eSpark-Consulting-Group/royluo-ledboard/README.md

# LED Board
#### Client Name: Roy Luo

## Project Requirements
### High Level PCB Requirements
- The PCB must be about 1.5cm by 1.5cm, with LED bulb extruding outwards in direction of the plane.
- Battery holder must be attached to the bottom of PCB board, and within that 1.5cm by 1.5cm dimension constraint.
- Battery holder will hold 2 CR1216 or CR1220 batteries, providing a battery life of at least 5 hours.
- Components must be chosen and sourced based on availability - we want components to be immediately available or available within at most 2 weeks for manufacturers to solder onto the PCB. Preferred is JLCPCB.
- The LED light will be flashing different colours, at different rates, to produce unique patterns when in motion, all of which is to be programmed and controlled via the microcontroller.
- Safety of the device is of high importance

### Key Electrical Components
- Addressable LED
    - Flashes 3 different colours at the same time
    - 16 possible colour options - can be reduced to save implementation costs
- Microcontroller
    - holds in memory the programmed colour settings (This point does not mean the memory should be retained when device goes off, it only means all the color combinations reside in flash so that they can be activated when device is ON)
    - controls the logic for user to change colour settings
- Button
    - Turns LED on/off (On press and hold of the button)
    - Sets light to colour selection mode
    - Cycle through colour selection
- Battery
    - 2 x CR1216 or CR1220 equivalent

### High Level Firmware Requirements
There are 3 states for the LED light:
1. OFF State
2. ON State
3. Cycle (Color Selection) State

- Pressing button once from OFF state turns LED to ON state
    - LED turns on upon release of button, not when button is pressed down
    - When in ON state, it will flash the first flash pattern in the cycle of patterns
- Pressing button once from ON state will make the LED flash the next pattern in the cycle
    - Pressing the button on the last pattern will take the user to the first pattern
- Pressing button and holding for 2 seconds from ON state turns LED to OFF state
- Pressing button and holding for 2 seconds from OFF state turns LED to Colour Selection state
    - LED will flash green for 2 seconds before entering colour selection mode
    - After the green flash the LED will stay on the first colour of the colour palette
    - Subsequent presses of the button will cycle the user through the colour palette
    - To choose a colour, press and hold on the desired colour, and the LED will flash that colour on and off for 1 second before returning to the first colour selection again
    - Repeat this 3 times to select the 3 colour choices, and after the final colour is selected, LED will flash the first flash pattern with the new colours
 
### Color Palette


### Strobe Pattern
Below are 5 strobe patterns we would like LED to be able to flash. Such patterns are made visible to the eye by waving the LED light around in circular motion.

#### 1. Standard Strobe


#### 2. Long Strobe


#### 3. Dots


#### 4. Flicker


#### 5. Streamline/ribbon


### Reference Product Images
