eSpark-Consulting-Group/royluo-ledboard/Docs/RD-CR1220-2 THM Type from Reida company.pdf

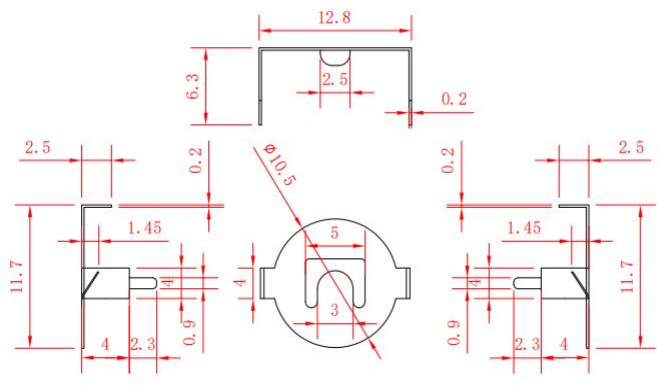
[picture p1: figure]

比例 SCALE | 单位 UNIT | 版本 REV. | 尺寸范围 SIZE RANGE | 公差 TOLERANCES | 零件编号 PART NO. | RD-CR1220-2 | 瑞达五金电子制品（东莞市）有限公司 LTD
| MM | A | XX. ±0.50 XX.X ±0.20 XX.XX ±0.10 XX.XXX ±0.05 GENERAL TOLERANCES PER ISO 2768-K | | 材料 MATERIAL | 0.20MM Mn STEEL | Reida Hardware Electronic (Dongguan) Co., 2X
制图 DRAWING | 审核 CHECKING | 核准 APPROVAL | | 表面处理 FINISH | 镀 镍 NICKEL PLATE | 零件名称 PART NAME | CR1220 BATTERY CLIP
CARSON | PETTER | J.L | | 日期 DATE | 2019/10/20 | 图纸编号 DWG NO. | RD-CR1220-2
