eSpark-Consulting-Group/royluo-ledboard/Design-Files/BOM/Royluo-Client-BOM.xlsx

# | Item Type | Designator | Description | Footprint | Manufacturer Part Number | Manufacturer | Value | Quantity | Remarks
1 | Capacitor | C1, C2, C3 | CAP CER 0.1UF 16V X7R 0402 | Cap-0402 | GRM155R71C104KA88D | Murata | 0.1uF | 3
2 | Capacitor | C4, C5 | CAP CER 10UF 10V X5R 0402 | Cap-0402 | CL05A106MP5NUNC | Samsung | 10uF | 2
3 | Capacitor | C6 | CAP CER 1UF 16V X5R 0402 | Cap-0402 | CC0402KRX5R7BB105 | Yageo | 1uF | 1
4 | Diode | D1 | 75V Dual 1.25V@150mA 4ns 150mA SOT-323 Switching Diode ROHS | SOT_323 | BAV99W | MSKSEMI | - | 1
5 | Connector | J1 | CR1220 2 cell connector | Custom | RD-CR1220-2 | Reida | - | 1 | Alibaba (https://www.alibaba.com/product-detail/Hot-Sale-DIP-Double-CR1220-Battery_1600451746414.html)
6 | RGB LED | LED1 | Plugin,D=5mm RGB LEDs ROHS | Custom | WS2812D-F5 | Worldsemi | - | 1
7 | Resistor | R1 | RES 75 OHM 5% 1/16W 0402 | Res-0402 | RC0402JR-0775RL | Yageo | 75R | 1
8 | Resistor | R2 | RES 10K OHM 1% 1/16W 0402 | Res-0402 | RC0402FR-0710KL | Yageo | 10K | 1
9 | Resistor | R3 | RES 1K OHM 1% 1/16W 0402 | Res-0402 | RC0402FR-071KL | Yageo | 1K | 1
10 | Resistor | R4 | RES 4.7K OHM 1% 1/16W 0402 | Res-0402 | RC0402FR-074K7L | Yageo | 4.7K | 1
11 | Tactile Switch | SW1 | 3.35mm 2.5mm Oval button 50mA Brick nogging 4.2mm 180gf 12V SMD Tactile Switches ROHS | Custom | TSA016A2518A | BZCN | - | 1
12 | IC | U1 | IC MCU 8BIT 4KB FLASH 8SOIC | SOIC-8(0.154", 3.90mm Width) | ATTINY412-SSNR | Microchip | - | 1
13 | LED Drivers | U2 | IC LED DRVR RGLTR 100MA SOT23-6 | SOT-23-6 | AP3602AKTR-G1 | Diodes | - | 1
14 | Peripheral | - | Coin Cell CR1220 | - | - | - | - | 2 | Aliexpress (https://www.aliexpress.com/item/1005006434761927.html)
