eSpark-Consulting-Group/royluo-ledboard/Design-Files/Supporting Files/royluo-ledboard.step

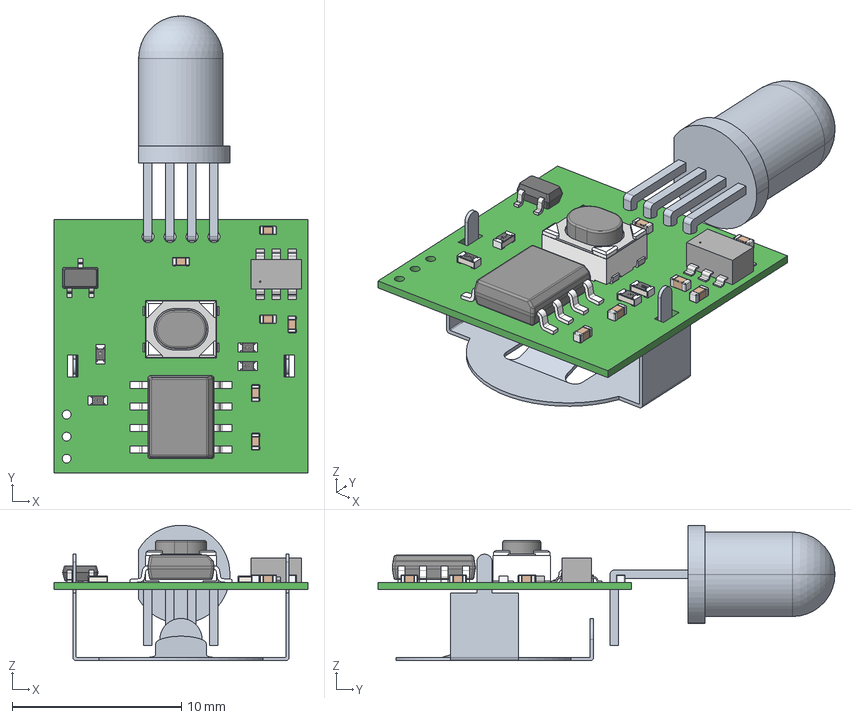
[picture p2: CAD file, 2024-05-24]
Design-Files/Supporting Files/royluo-ledboard.step
15.0 x 27.0 x 8.01 mm
LED
CR1220-2CELL
21-0058I_MXM
BODY-SO
LEAD-D0008A x 8
User Library-RES_1005-0402 x 4
User Library-sc70-3
User Library-Capacitor 0402 x 6
