eSpark-Consulting-Group/royluo-ledboard/(list of files, cad)

Other CAD files:
Design-Files/Supporting Files/royluo-ledboard.DWG
Design-Files/Supporting Files/royluo-ledboard.DXF
