eSpark-Consulting-Group/royluo-ledboard/Design-Files/Schematic/royluo-ledboard.pdf

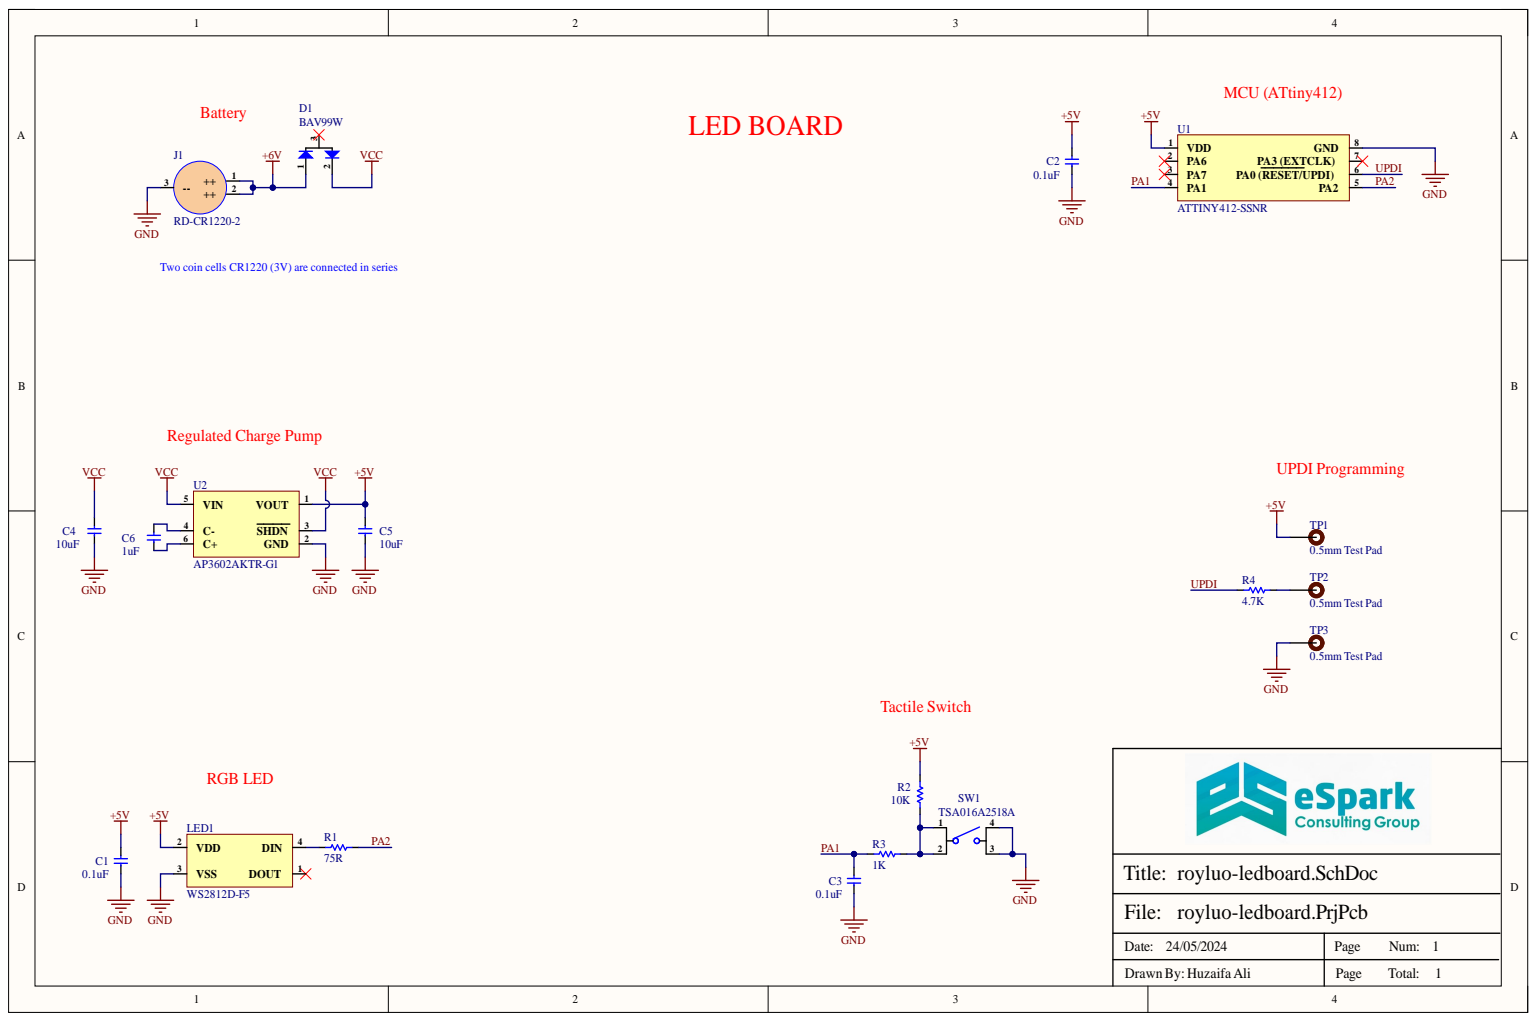
[picture p3: page 1]

Two coin cells CR1220 (3V) are connected in series
