eSpark-Consulting-Group/royluo-ledboard/(list of files, drawings)

Other design files:
Design-Files/royluo-ledboard.PcbDoc
Design-Files/royluo-ledboard.PrjPcb
Design-Files/royluo-ledboard.SchDoc
