eSpark-Consulting-Group/royluo-ledboard/(commit log)

2024-05-17 gitignore added. Design template added
    [LED-Board-v1.0.PrjPcb, LED-Board.SchDoc]
2024-05-21 #1 (move from main to development v1.0)
    [royluo-ledboard.PrjPcb, royluo-ledboard.SchDoc]
2024-05-21 #1 (Replaced 0603 components with 0402)
    [LED-Board-v1.0.PrjPcb, LED-Board.SchDoc, royluo-ledboard.PrjPcb, royluo-ledboard.SchDoc]
2024-05-22 #3 (PCB Design In Progress)
    [royluo-ledboard.PcbDoc, royluo-ledboard.PrjPcb, royluo-ledboard.SchDoc]
2024-05-23 #3 Complete.
    [royluo-ledboard.PcbDoc, royluo-ledboard.PrjPcb, royluo-ledboard.SchDoc]
2024-05-23 #3 New CR1220 Added. PCB Complete.
    [royluo-ledboard.PcbDoc, royluo-ledboard.SchDoc]
2024-05-24 #3 LED 3D Body Added
    [royluo-ledboard.PcbDoc, royluo-ledboard.SchDoc]
2024-05-24 CR1220 Datasheet + Schematic PDF
    [royluo-ledboard.PrjPcb]
2024-05-24 Extra files deleted; schematic folder location moved
2024-05-24 Project Deliverables
    [Centroid.csv, Pick Place for royluo-ledboard.csv, Royluo-Client-BOM.xlsx, royluo-ledboard.DWG, royluo-ledboard.DXF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]
2024-05-24 Peripherals Added in BOM.
    [Royluo-Client-BOM.xlsx]
